zharfanw/fsaetest/Circuit/Gallery/AccumulatorCircuit.jpg

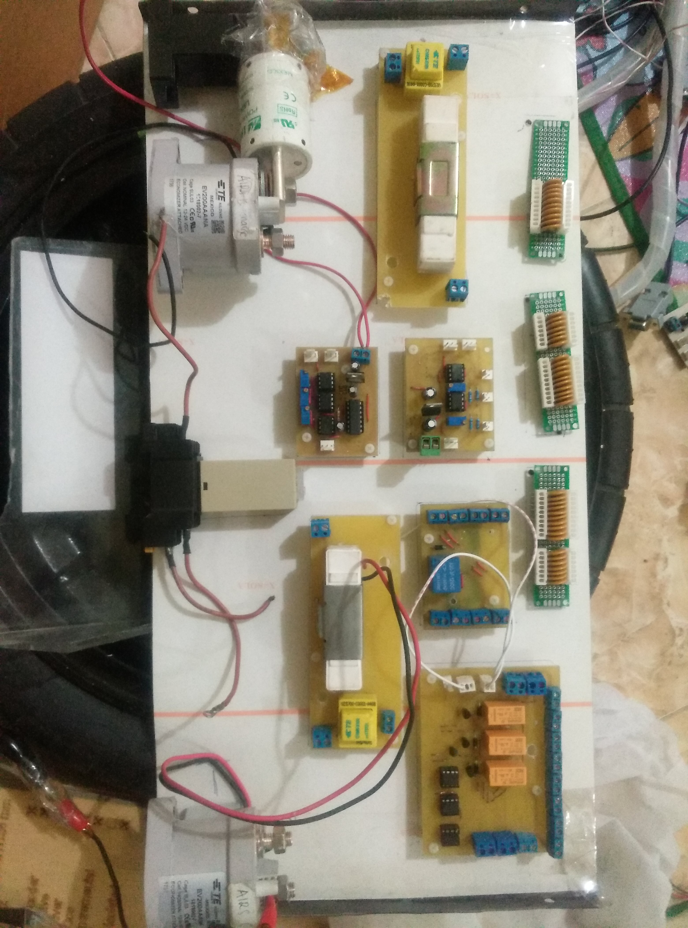
Circuit/Gallery/AccumulatorCircuit.jpg
