zharfanw/fsaetest/Circuit/Gallery/Diagram.png

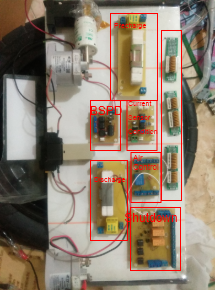
Circuit/Gallery/Diagram.png
