zharfanw/fsaetest/README.md

# UII's FSAE Car TEST

<!--stackedit_data:
eyJoaXN0b3J5IjpbNDYwMDQ0OTMzXX0=
-->
