zharfanw/fsaetest/Circuit/OrionBMSControl/FotoSementara.JPG

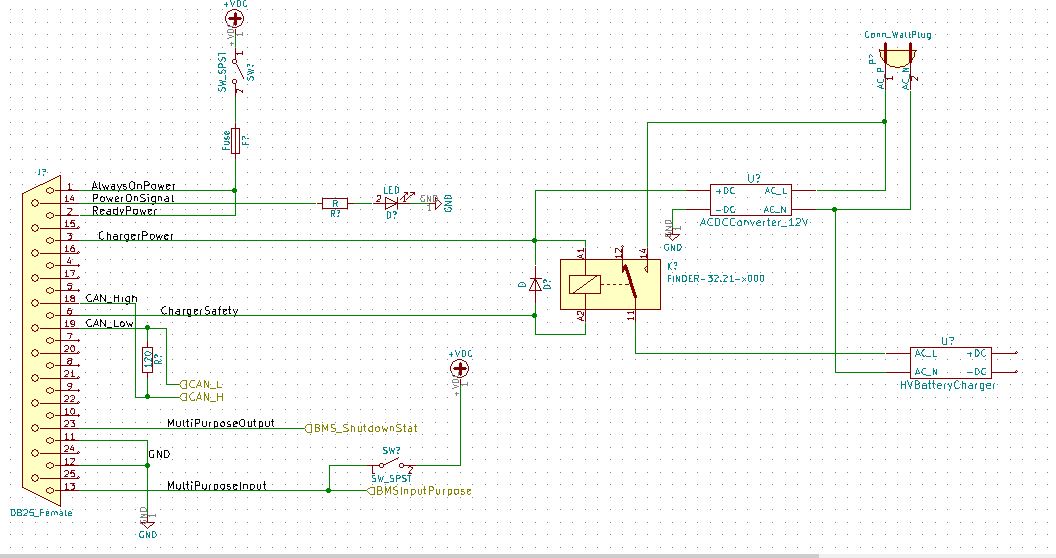
Circuit/OrionBMSControl/FotoSementara.JPG
