zharfanw/fsaetest/Circuit/OrionBMSControl/MultiIOPurpose.JPG

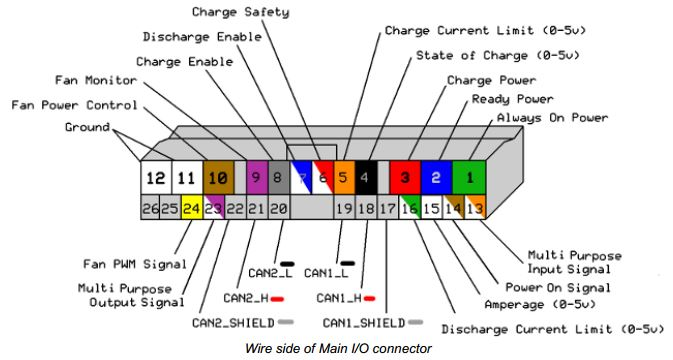
Circuit/OrionBMSControl/MultiIOPurpose.JPG
