zharfanw/fsaetest/Document/WiringData.ods

Sheet: NodeRegion
No | NodeRegion | NodeRegionSymbol
1 | Dashboard | D
2 | Pedal | P
3 | ECU | E
4 | Radiator | R
5 | PDM | PD
6 | Aki | BLV
7 | Rollbar | RB
8 | HVEnclosure | HVE
9 | Accumulator | Ac
10 | MotorController | MC
11 | Motor | M
12 | BMS | B
13 | HVEnclosure | Hve
14 | RightPanel | RP

Sheet: Node
No | Node1 |  |  | Node2 |  |  | LinkName |  |  |  | Note | Kabel | Links
 | NodeRegion | Node | NodeSym | NodeRegion | Node | NodeSym | From | To | Name | FULLNAME
1 | Pedal | +V_APP1 | +VAP1 | ECU | +V_APP1 | +VAP1 | P | E | +VAP1 | P_E_+VAP1 |  | 6P_AWG24 | https://www.tokopedia.com/s3-satriasecure/awg-kabel-6-jalur-bungkus-double-selongsong-bulat-isi-6-warna
2 | Pedal | APP1 | AP1 | ECU | APP1 | AP1 | P | E | AP1 | P_E_AP1
3 | Pedal | GND_APP1 | GAP1 | ECU | GND_APP1 | GAP1 | P | E | GAP1 | P_E_GAP1
4 | Pedal | +V_APP2 | +VAP2 | ECU | +V_APP2 | +VAP2 | P | E | +VAP2 | P_E_+VAP2
5 | Pedal | APP2 | AP1 | ECU | APP2 | AP1 | P | E | AP1 | P_E_AP1
6 | Pedal | GND_APP2 | GAP1 | ECU | GND_APP2 | GAP1 | P | E | GAP1 | P_E_GAP1
7 | Pedal | +V_BPP1 | +VBP1 | ECU | +V_BPP1 | +VBP1 | P | E | +VBP1 | P_E_+VBP1 |  | 6P_AWG24 | https://www.tokopedia.com/s3-satriasecure/awg-kabel-6-jalur-bungkus-double-selongsong-bulat-isi-6-warna
8 | Pedal | BPP1 | BP1 | ECU | BPP1 | BP1 | P | E | BP1 | P_E_BP1
9 | Pedal | GND_BPP1 | GBP1 | ECU | GND_BPP1 | GBP1 | P | E | GBP1 | P_E_GBP1
10 | Pedal | +V_BPP2 | +VBP2 | ECU | +V_BPP2 | +VBP2 | P | E | +VBP2 | P_E_+VBP2
11 | Pedal | BPP2 | BP2 | ECU | BPP2 | BP2 | P | E | BP1 | P_E_BP1
12 | Pedal | GND_BPP2 | GBP2 | ECU | GND_BPP2 | GBP2 | P | E | GBP1 | P_E_GBP1
13 | Pedal | BOTS_IN |  | Accumulator | Dashboard_SD_IN | D_SD_IN | P | Ac | SD | P_Ac_SD | SerialConnected | 2p_AWG20 | https://www.tokopedia.com/selectronix/high-quality-kabel-2-x-20-awg-1-meter?whid=0
14 | Pedal | BOTS_OUT |  | Accumulator | Dashboard_SD_IN | D_SD_OUT | P | Ac | SD | P_Ac_SD | SerialConnected
15 | Pedal | BRAKE_Switch_IN |  | PDM |  |  | P | PD | BS | P_PD_BS |  | 2p_AWG20 | https://www.tokopedia.com/selectronix/high-quality-kabel-2-x-20-awg-1-meter?whid=0
16 | Pedal | BRAKE_Switch_OUT |  | PDM |  |  | P | PD | BS | P_PD_BS
17 | Dashboard | CAN_H |  | ECU | CAN_H |  | D | E | CANH | D_E_CANH | ParalelConnected | 3p_AWG24 | https://www.tokopedia.com/s3-satriasecure/kabel-awg-24-3-jalur-double-bungkus-selongsong-awg24-bulat-isi-3-warna
18 | Dashboard | CAN_L |  | ECU | CAN_L |  | D | E | CANL | D_E_CANL | ParalelConnected
19 | Dashboard | DriveMode_In | FD_IN | MotorController | ForwardDigital_IN |  | D | MC | FD | D_MC_FD | SerialConnected | 8P_AWG24 | https://www.tokopedia.com/s3-satriasecure/awg24-kabel-8-jalur-bungkus-double-selongsong-awg24-bulat-isi-8-warna
20 | Dashboard | DriveMode_Out | FD_OUT | MotorController | ForwardDigital_OUT |  | D | MC | FD | D_MC_FD | SerialConnected
21 | Dashboard | ReverseDigInput_IN | RD_IN | MotorController | ReverseDigInput_IN | RD_IN | D | MC | RD | D_MC_RD
22 | Dashboard | ReverseDigInput_OUT | RD_OUT | MotorController | ReverseDigInput_OUT | RD_OUT | D | MC | RD | D_MC_RD
23 | Dashboard | MotorCAN_H | MCAN_H | MotorController | MotorCAN_H | MCAN_H | D | MC | MCAN_H | D_MC_MCAN_H
24 | Dashboard | MotorCAN_L | MCAN_L | MotorController | MotorCAN_L | MCAN_L | D | MC | MCAN_L | D_MC_MCAN_L
25 | Dashboard | VCC | VDB | PDM |  |  | D | PD | VDB | D_PD_VDB |  | 2p_AWG20 | https://www.tokopedia.com/selectronix/high-quality-kabel-2-x-20-awg-1-meter?whid=0
26 | Dashboard | GND | GDB | PDM |  |  | D | PD | GDB | D_PD_GDB
27 | Dashboard | BMS_Indicator | BMSIN | Accumulator | BMS_Indicator | BMSIN | D | Ac | BMSIN | D_Ac_BMSIN |  | 4p_AWG24 | https://www.tokopedia.com/s3-satriasecure/kabel-awg-24-4-jalur-double-bungkus-selongsong-awg24-bulat-isi-4-warna
28 | Dashboard | IMD_Indicator | IMDIN | Accumulator | IMD_Indicator | IMDIN | D | Ac | IMDIN | D_Ac_IMDIN
29 | Dashboard | GND_Indicator | GNDIN | Accumulator | GND_Indicator | GNDIN | D | Ac | GNDIN | D_Ac_GNDIN
30 | Dashboard | MotorControllerIgnition_IN | MCIG_IN | MotorController | GND_Ignition | MCIG_IN | D | MC | MCIG_IN | D_MC_MCIG_IN | SerialConnected | 2p_AWG20 | https://www.tokopedia.com/selectronix/high-quality-kabel-2-x-20-awg-1-meter?whid=0
31 | Dashboard | MotorControllerIgnition_OUT | MCIG_OUT | MotorController | Ignition | MCIG_OUT | D | MC | MCIG_OUT | D_MC_MCIG_OUT | SerialConnected
32 | Dashboard | Shutdown_Dashboard_IN | SD_DB_IN | Accumulator | Shutdown_Dashboard_IN | SD_DB_IN | D | Ac | SD_DB_IN | D_Ac_SD_DB_IN |  | 2p_AWG20 | https://www.tokopedia.com/selectronix/high-quality-kabel-2-x-20-awg-1-meter?whid=0
33 | Dashboard | Shutdown_Dashboard_OUT | SD_DB_OUT | Accumulator | Shutdown_Dashboard_OUT | SD_DB_OUT | D | Ac | SD_DB_OUT | D_Ac_SD_DB_OUT
34 | ECU | VCC | VECU | PDM |  |  | E | PD | VECU | E_PD_VECU |  | 2p_AWG20
35 | ECU | GND | GECU | PDM |  |  | E | PD | GECU | E_PD_GECU
36 | ECU | MotorControllerIgnition_IN | MCIG_IN | MotorController | GND_Ignition |  | E | MC | MCIG_IN | E_MC_MCIG_IN | SerialConnected | 2p_AWG20
37 | ECU | MotorControllerIgnition_OUT | MCIG_OUT | MotorController | Ignition |  | E | MC | MCIG_OUT | E_MC_MCIG_OUT | SerialConnected
38 | ECU | Vthrottle_MotorController | VTMC | MotorController | ThrottleVCCOut |  | E | MC | VTMC | E_MC_VTMC |  | 3p_AWG24 | https://www.tokopedia.com/s3-satriasecure/kabel-awg-24-3-jalur-double-bungkus-selongsong-awg24-bulat-isi-3-warna
39 | ECU | SignalThrottle_MotorController | STMC | MotorController | ThrottleInput |  | E | MC | STMC | E_MC_STMC
40 | ECU | GNDThrottle_MotorController | GTMC | MotorController | GND_Ignition |  | E | MC | GTMC | E_MC_GTMC | ParallelConnected
41 | ECU | Vbrake | VB | Accumulator | V brakeSensor |  | E | Ac | VB | E_Ac_VB |  | 3p_AWG24 | https://www.tokopedia.com/s3-satriasecure/kabel-awg-24-3-jalur-double-bungkus-selongsong-awg24-bulat-isi-3-warna
42 | ECU | Sbrake | SB | Accumulator | S_brakeSensor |  | E | Ac | SB | E_Ac_SB
43 | ECU | Gbrake | GB | Accumulator | G_BrakeSensor |  | E | Ac | GB | E_Ac_GB
44 | BMS | AlwaysOnPower%PowerOnSignal | VBMS | PDM |  |  | B | PD | VBMS | B_PD_VBMS |  | 2p_AWG20
45 | BMS | GND | GBMS | PDM |  |  | B | PD | GBMS | B_PD_GBMS
46 | BMS | CANH | CANH | ECU | CAN_H |  | B | E | CANH | B_E_CANH |  | 3p_AWG24
47 | BMS | CANL | CANL | ECU | CAN_L |  | B | E | CANL | B_E_CANL
48 | BMS | MultiPurposeInput | BMPI | ECU | BMS_MultiPurposeInput | BMPI | B | E | BMPI | B_E_BMPI |  | 2p_AWG20
49 | BMS | MultiPurposeOuput | BMPO | Accumulator | BMS_Input | BMSI | B | Ac | BMPO | B_Ac_BMPO |  | 2p_AWG20
50 | Accumulator | +LV | Vac | PDM |  |  | Ac | PD | Vac | Ac_PD_Vac |  | 2p_AWG20
51 | Accumulator | GND | Gac | PDM |  |  | Ac | PD | Gac | Ac_PD_Gac
52 | Accumulator | SmallHV+ | SHV+ | HVEnclosure | HV+ |  | Ac | HVE | SHV+ | Ac_HVE_SHV+ |  | 2p_AWG20
53 | Accumulator | SmallHV- | SHV- | HVEnclosure | HV- |  | Ac | HVE | SHV- | Ac_HVE_SHV-
54 | Accumulator | DischargeSignal | DS | HVEnclosure | DischargeSignal |  | Ac | HVE | DS | Ac_HVE_DS |  | 2p_AWG20
55 | Accumulator | Discharge_GND | DG | HVEnclosure | Discharge_GND |  | Ac | HVE | DG | Ac_HVE_DG
56 | HVEnclosure | TSALV+ | TSV+ | Rollbar | +V_TSALSIGNAL |  | HVE | RB | TSV+ | HVE_RB_TSV+ |  | 2p_AWG20
57 | HVEnclosure |  | TSV- | Rollbar | -V_TSALSIGNAL |  | HVE | RB | TSV- | HVE_RB_TSV-
58 | HVEnclosure | TSALV- | TSMP+ | Rollbar | TSMP_HV+ |  | HVE | RB | TSMP+ | HVE_RB_TSMP+ |  | 2p_AWG20
59 | HVEnclosure | TSMP_HV+ | TSMP- | Rollbar | TSMP_HV- |  | HVE | RB | TSMP- | HVE_RB_TSMP-
60 | HVEnclosure | TSMP_R_HV+ | RTSMP+ | Rollbar | TSMP_R_HV+ |  | HVE | RB | RTSMP+ | HVE_RB_RTSMP+ |  | 2p_AWG20
61 | HVEnclosure | TSMP_R_HV+ | RTSMP- | Rollbar | TSMP_R_HV+ |  | HVE | RB | RTSMP- | HVE_RB_RTSMP-
62 | Rollbar | TSMP_GND | GMP | PDM |  |  | RB | PD | GMP | RB_PD_GMP |  | 2p_AWG20
63 | RightPanel | Reset_IN | Rin | Accumulator | Reset_In |  | RP | Ac | Rin | RP_Ac_Rin |  | 2p_AWG20
64 | RightPanel | Reset_Out | Rout | Accumulator | Reset_Out |  | RP | Ac | Rout | RP_Ac_Rout
65 | RightPanel | LV_MS_IN | LVMSIn | PDM |  |  | RP | PD | LVMSIn | RP_PD_LVMSIn |  | 2p_AWG20
66 | RightPanel | LV_MS_OUT | LVMSOut | PDM |  |  | RP | PD | LVMSOut | RP_PD_LVMSOut
 | RightPanel | Shutdown_TSMS_IN | SD_TS_IN | Accumulator |  |  | RP | Ac | SD_TS_IN | RP_Ac_SD_TS_IN |  | 2p_AWG20
 | RightPanel | Shutdown_TSMS_IN | SD_TS_OUT | Accumulator |  |  | RP | Ac | SD_TS_OUT | RP_Ac_SD_TS_OUT
67 | Rollbar | Shutdown_Rollbar_IN | SD_RB_IN | Accumulator | Shutdown_IN |  | RB | Ac | SD_RB_IN | RB_Ac_SD_RB_IN |  | 2p_AWG20
68 | Rollbar | Shutdown_Rollbar_OUT | SD_RB_OUT | Accumulator | Shutdown_OUT |  | RB | Ac | SD_RB_OUT | RB_Ac_SD_RB_OUT
69 | MotorController | SSIClock+ | SSICK+ | Motor | SSIClock+ | SSICK+ | MC | M | SSICK+ | MC_M_SSICK+ |  | 8P_AWG24 | https://www.tokopedia.com/s3-satriasecure/awg24-kabel-8-jalur-bungkus-double-selongsong-awg24-bulat-isi-8-warna
70 | MotorController | SSIClock- | SSICK- | Motor | SSIClock- | SSICK- | MC | M | SSICK- | MC_M_SSICK-
71 | MotorController | SSIData+ | SSID+ | Motor | SSIData+ | SSID+ | MC | M | SSID+ | MC_M_SSID+
72 | MotorController | SSIData- | SSID- | Motor | SSIData- | SSID- | MC | M | SSID- | MC_M_SSID-
73 | MotorController | Feedback_VCC | FBV | Motor | Feedback_VCC | FBV | MC | M | FBV | MC_M_FBV
74 | MotorController | Feedback_GND | FBG | Motor | Feedback_GND | FBG | MC | M | FBG | MC_M_FBG
75 | MotorController | MotorTemperature | MT | Motor | MotorTemperature | MT | MC | M | MT | MC_M_MT
76 | Radiator | Radiator_FAN_V+ | RFV+ | PDM |  |  | R | PD | RFV+ | R_PD_RFV+ |  | 2p_AWG20
77 | Radiator | Radiator_FAN_V- | RFV- | PDM |  |  | R | PD | RFV- | R_PD_RFV-
78 | Radiator | Radiator_Pump_V+ | RPV+ | PDM |  |  | R | PD | RPV+ | R_PD_RPV+ |  | 2p_AWG20
79 | Radiator | Radiator_Pump_V- | RPV- | PDM |  |  | R | PD | RPV- | R_PD_RPV-
80 | Aki | V+ | V+ | PDM |  |  | BLV | PD | V+ | BLV_PD_V+
81 | Aki | V- | V- | PDM |  |  | BLV | PD | V- | BLV_PD_V-

Sheet: Ukuran
No | From | To | Size
1 | S1 | Pedal | 90
 | S1 | Dashboard | 90
 | S2 | ECU | 30
 | S1 | S2 | 84
 | S2 | S4 | 49
 | S4 | S3 | 33
 | S3 | Rollbar | 108
 | S3 | RightPanel | 37
 | S4 | MotorController | 83
 | S4 | PDM | 83
 | S4 | HVEnclosure | 83
 | S4 | S5 | 55
 | S5 | BMS | 53
 | S5 | Accumulator | 53
 | S5 | Aki | 53
 | S5 | RadiatorFan | 90
 | S5 | BrakeLight | 90
 | Pedal | ECU | 120
 | Pedal | Accumulator | 282
 | Pedal | PDM | 306
 | ECU | PDM | 246
 | ECU | BMS | 222 | 222
 | ECU | MotorController | 246 | 246
 | ECU | Accumulator | 222 | 222
 | Dashboard | PDM | 306 | 306
 | Dashboard | Accumulator | 282 | 282
 | Dashboard | MotorController | 293 | 293 | 306
 | Dashboard | BMS | 282
 | MotorController | PDM | 169
 | MotorController | Motor | 150
 | BMS | Accumulator | 90
 | Accumulator | PDM | 240 | 240
 | Accumulator | HVEnclosure | 240 | 240
 | Accumulator | Rollbar | 227 | 227
 | Accumulator | RightPanel | 227 | 227
 | HVEnclosure | Rollbar | 224 | 224
 | HVEnclosure | PDM | 169
 | RightPanel | PDM | 153 | 153
 | Radiator | PDM | 277 | 277
 | PDM | BrakeLight | 277
