zharfanw/fsaetest/Circuit/All General Wiring/All General Wiring.pdf

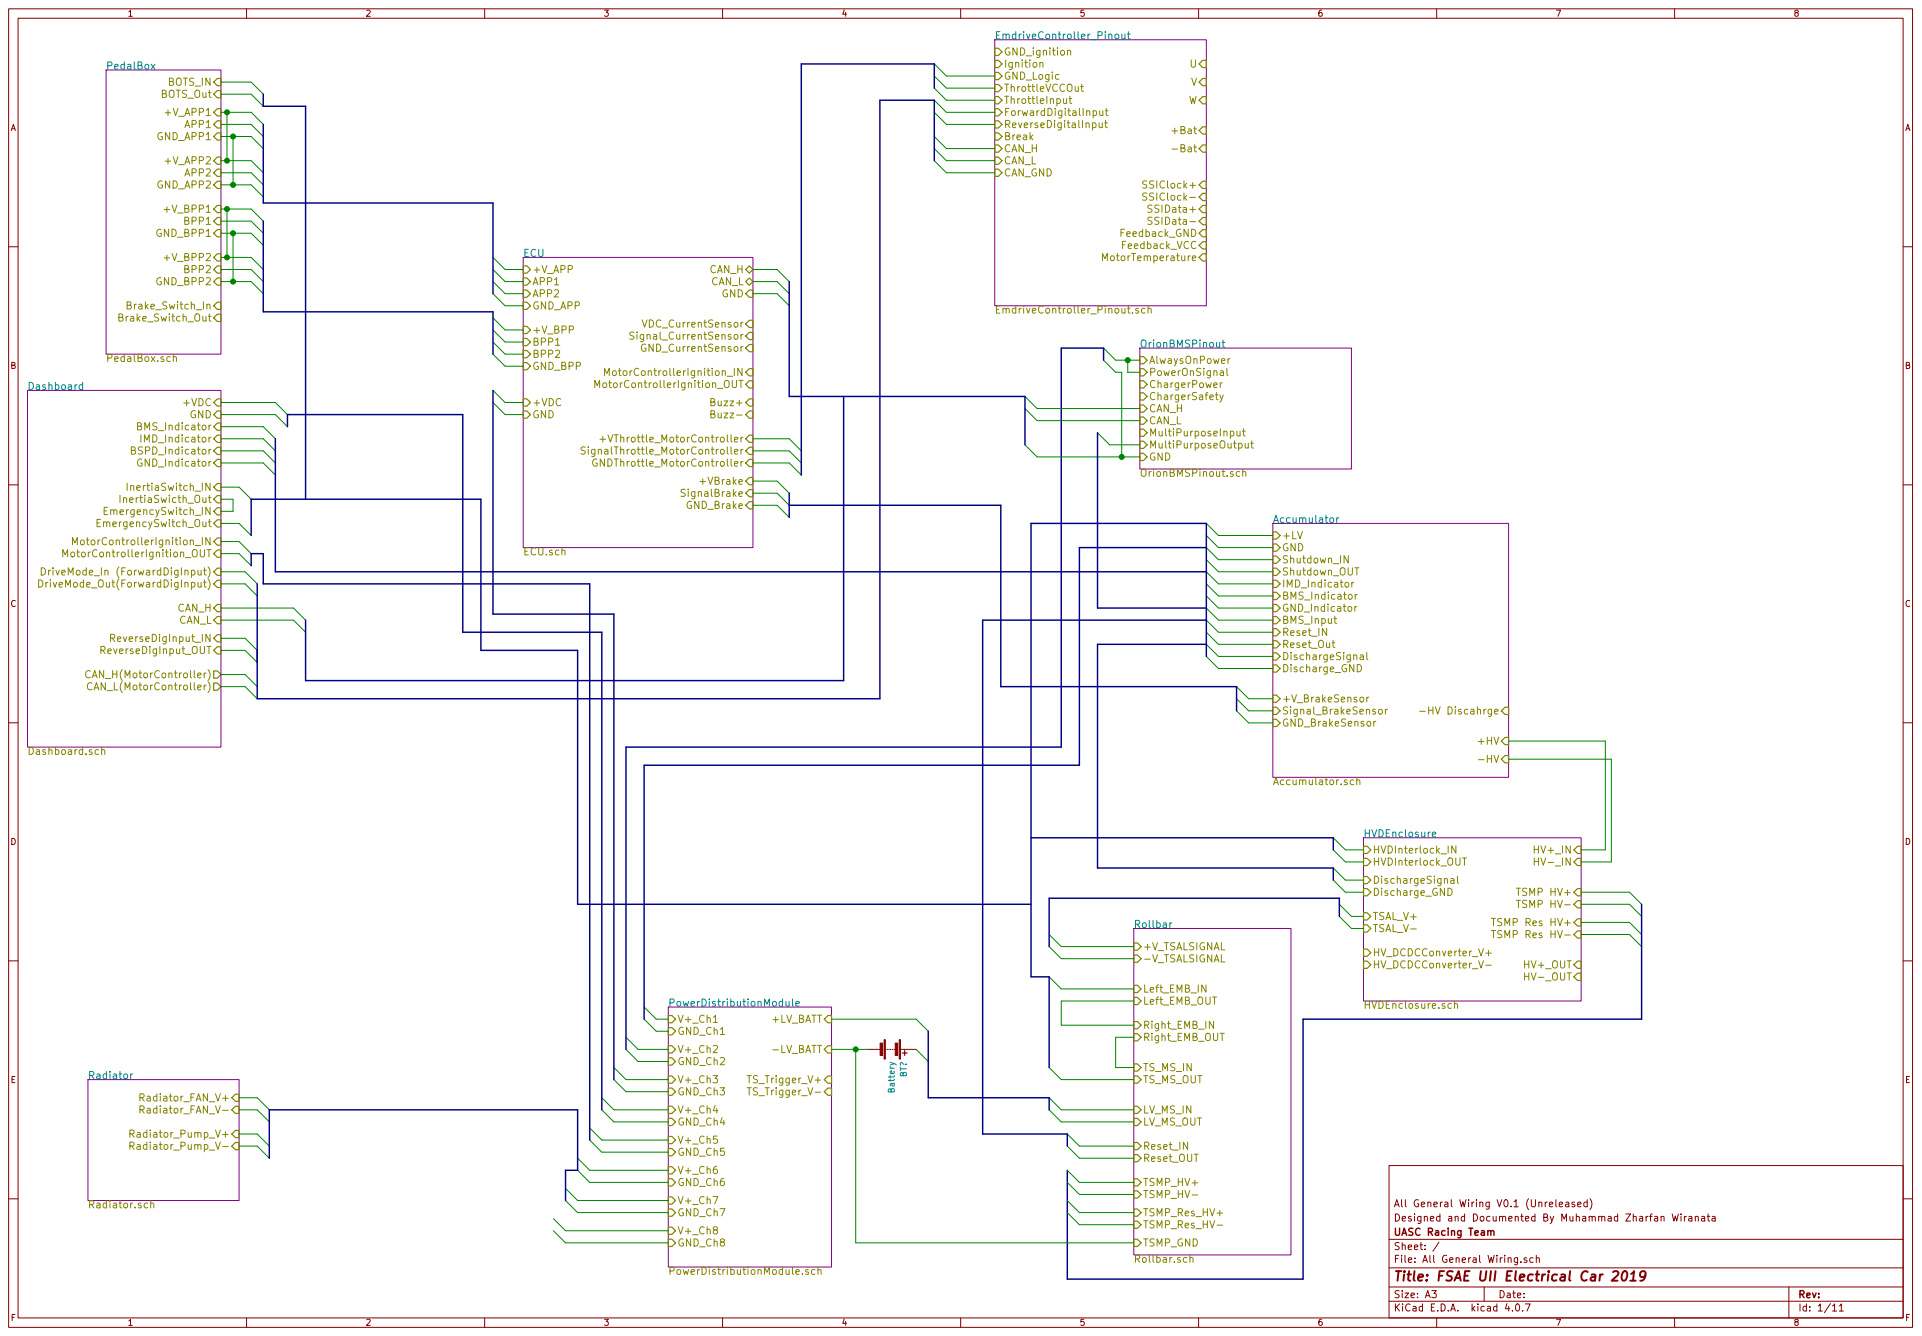
[picture p6: page 1]
