zharfanw/fsaetest/Circuit/OldSchematic/Shutdown/AIRControl.PDF

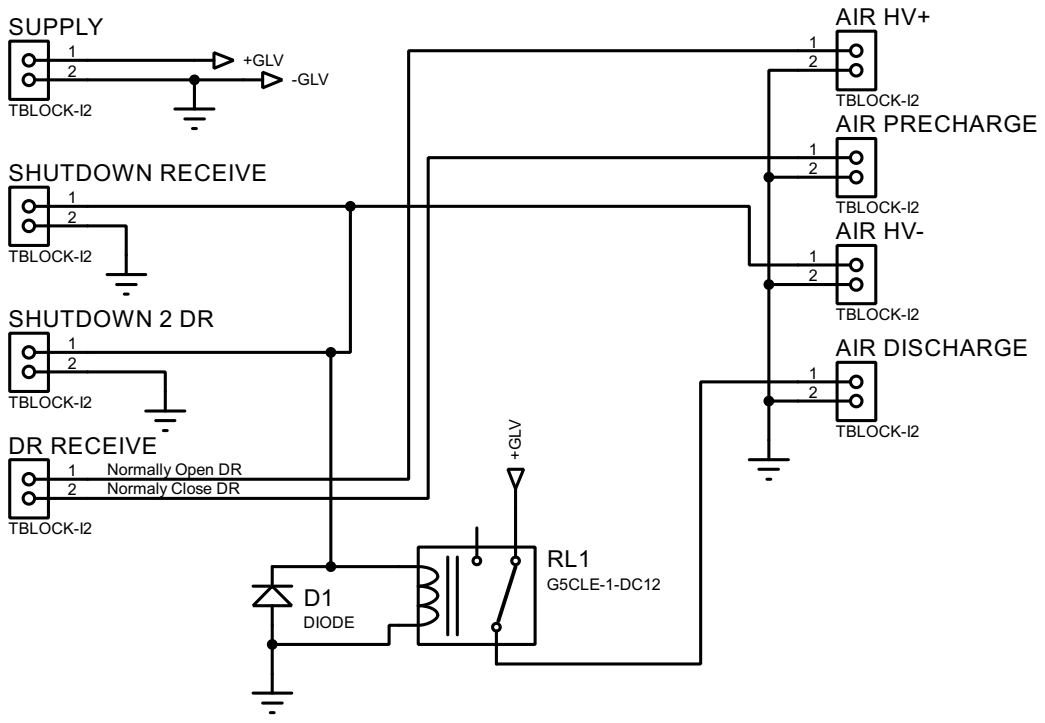
[picture p7: page 1]

FILE NAME:
DESIGN TITLE: AIRControl.pdsprj
