zharfanw/fsaetest/Circuit/OldSchematic/Shutdown/BSPD_UASC.PDF

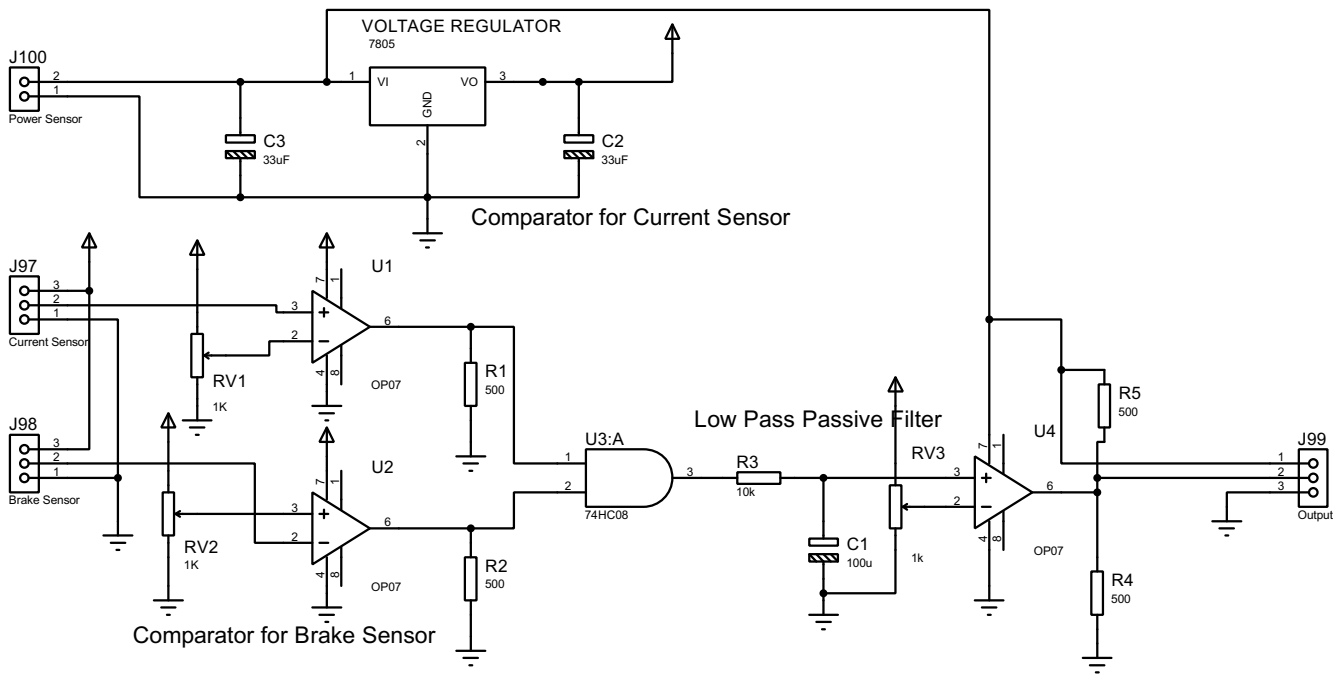
[picture p8: page 1]
