zharfanw/fsaetest/Circuit/OldSchematic/Shutdown/BSPD_UASC_PCB.PDF

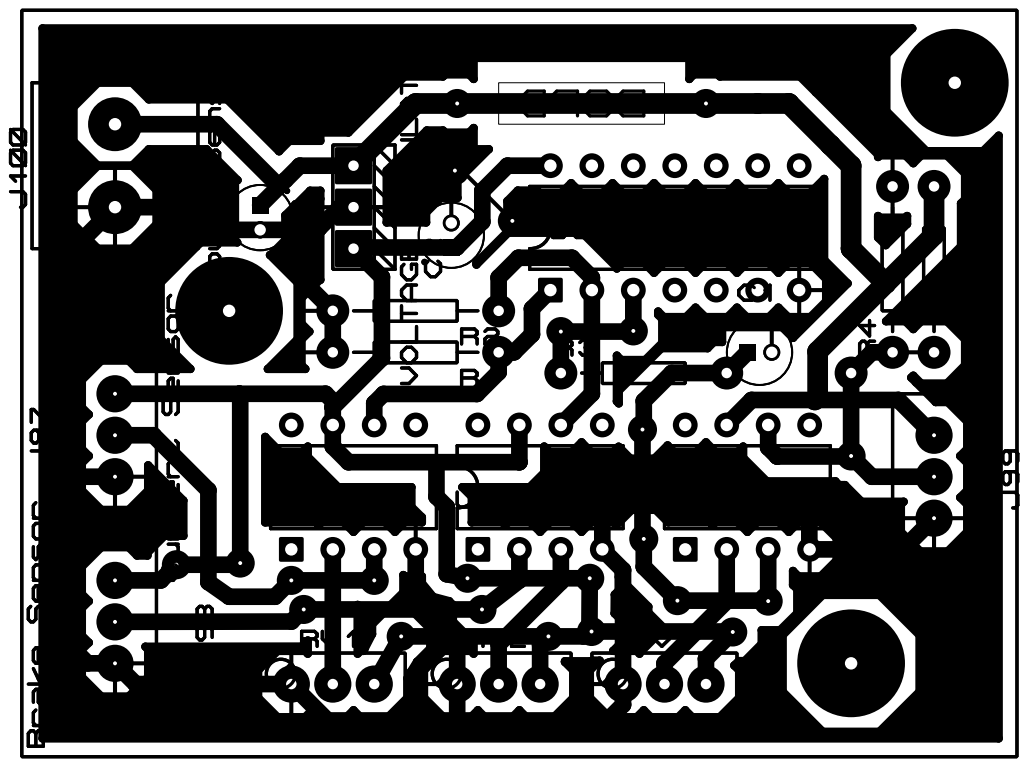
[picture p9: page 1]
