zharfanw/fsaetest/Circuit/OldSchematic/Shutdown/BSPDv2.PDF

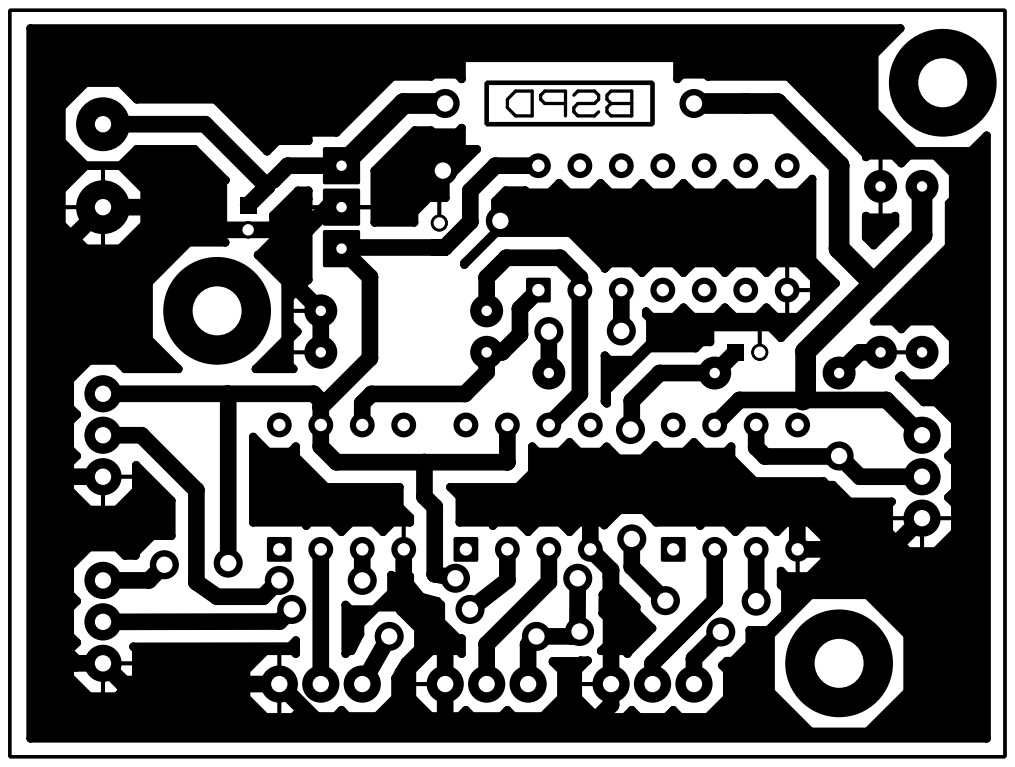
[picture p10: page 1]
