zharfanw/fsaetest/Circuit/OldSchematic/Shutdown/CurrentSensor_SignalConditioning.PDF

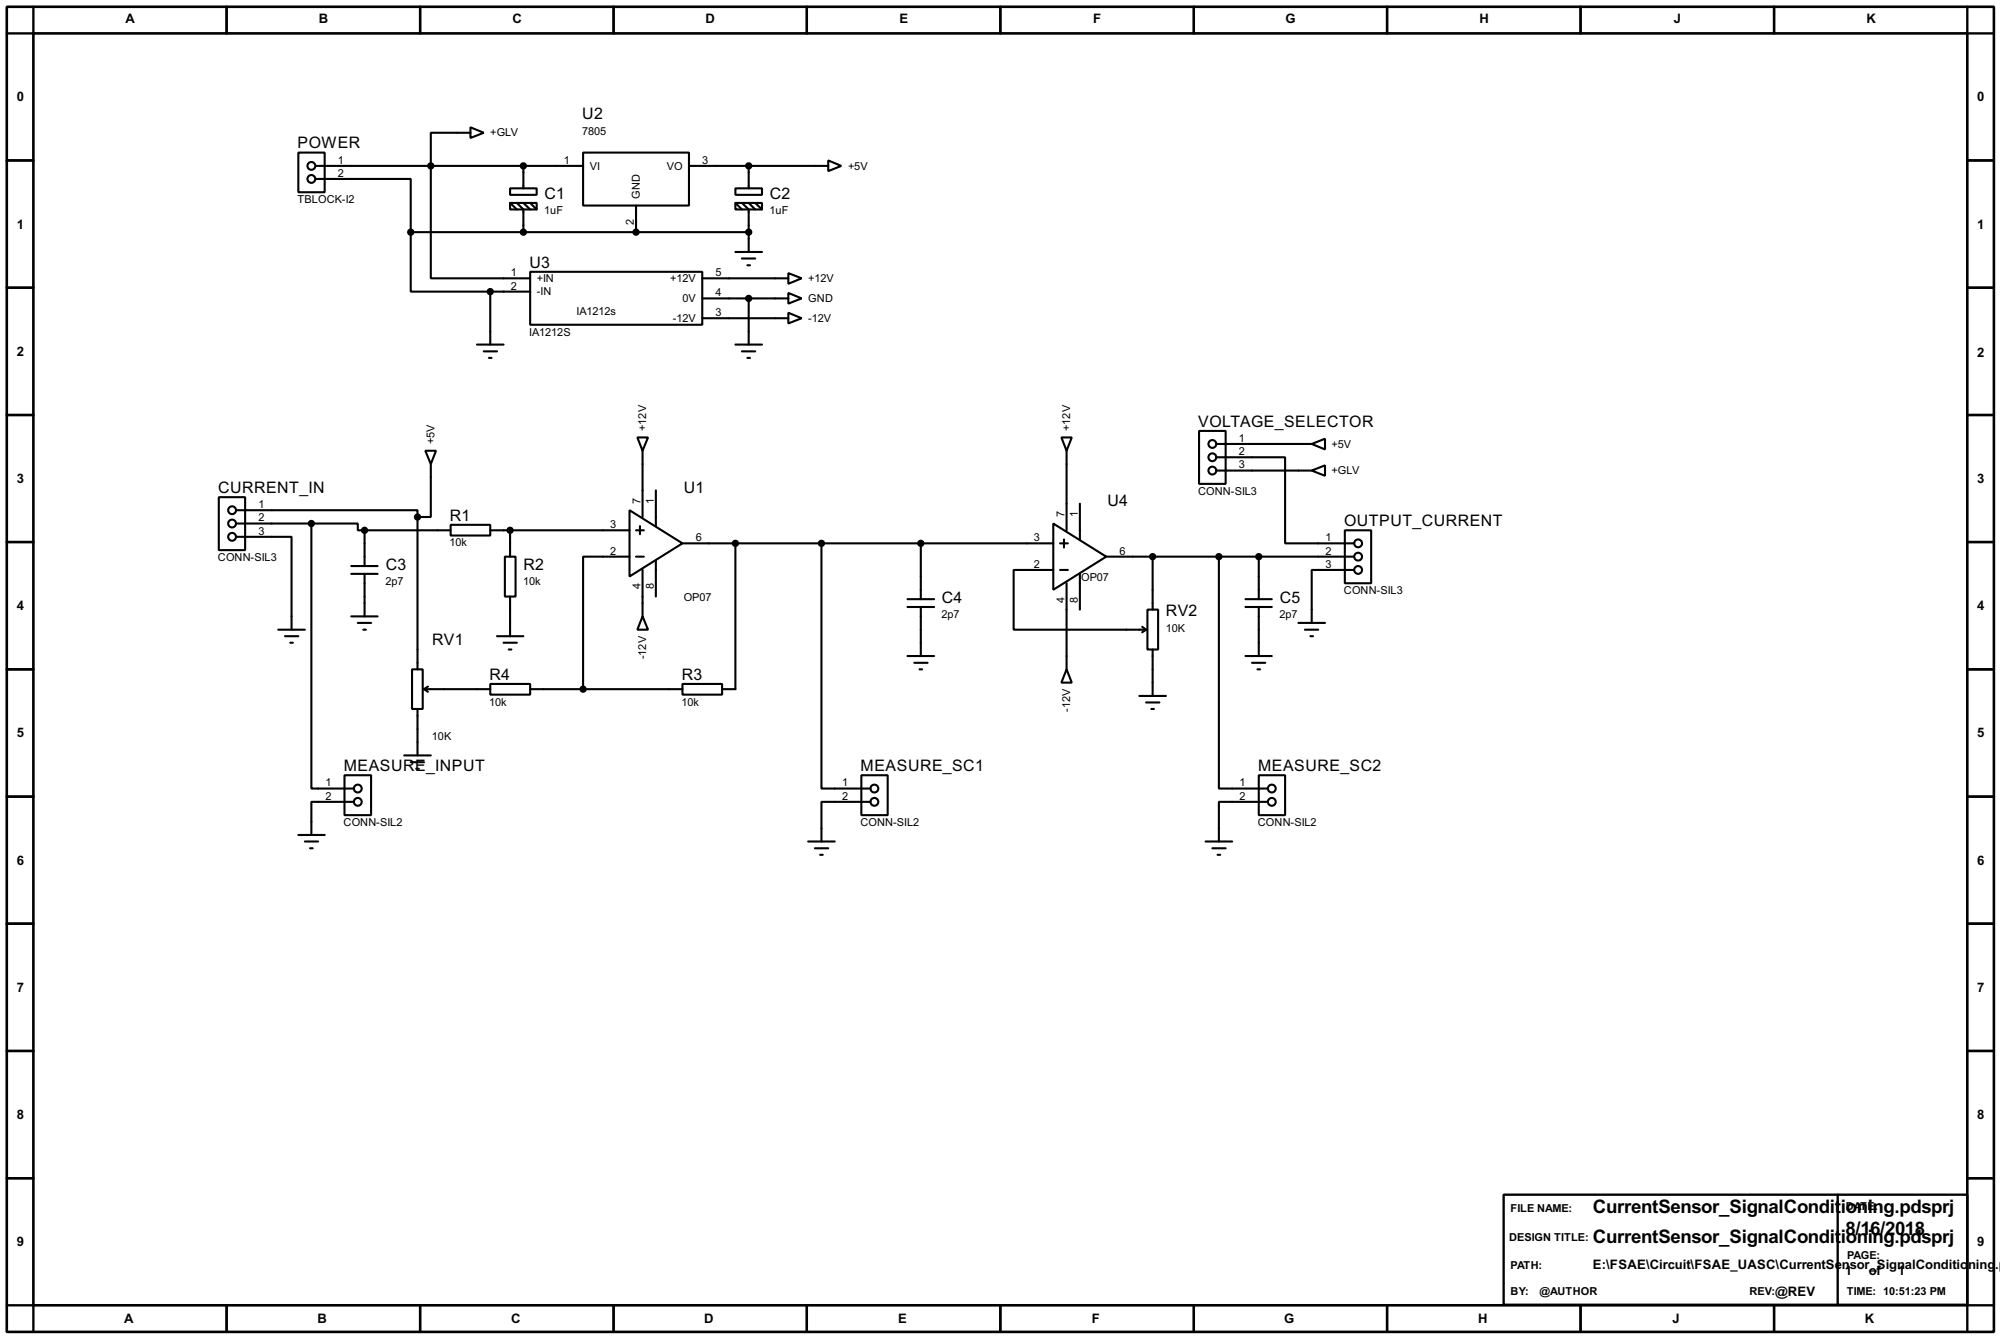
[picture p11: page 1]
