zharfanw/fsaetest/Circuit/OldSchematic/Shutdown/CurrentSensor_SignalConditioning_PCB.PDF

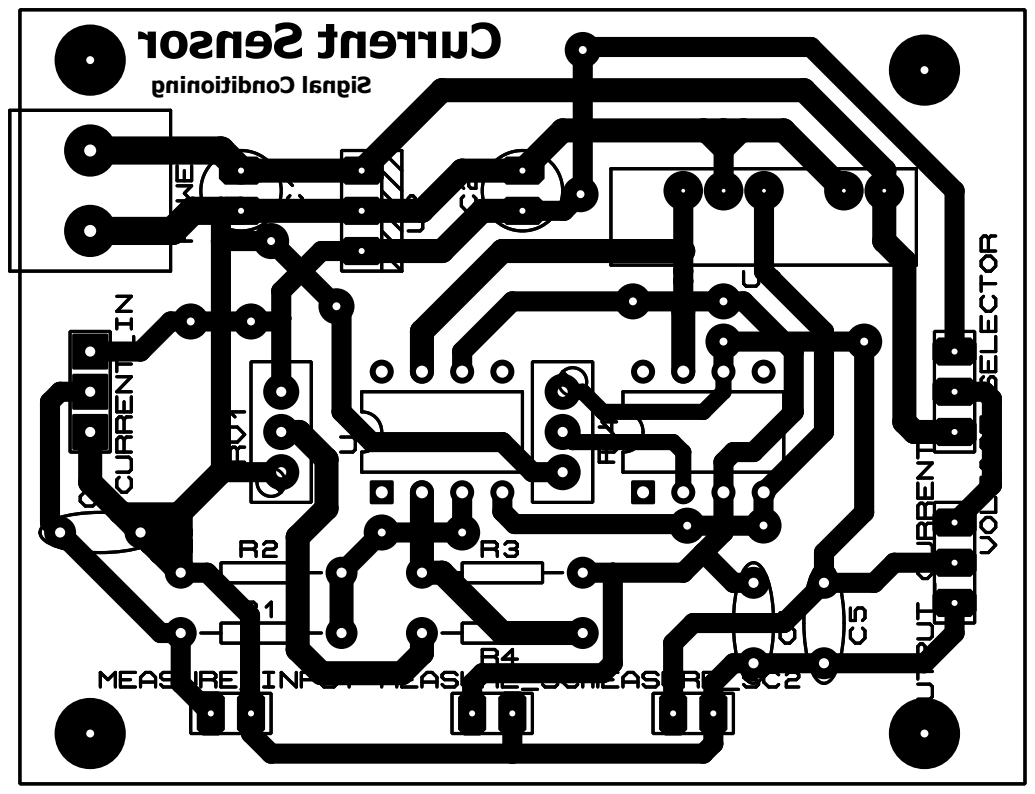
[picture p12: page 1]

gni noiti dnoCl angi S
