zharfanw/fsaetest/Circuit/OldSchematic/Shutdown/Shutdown_Circuitv3.PDF

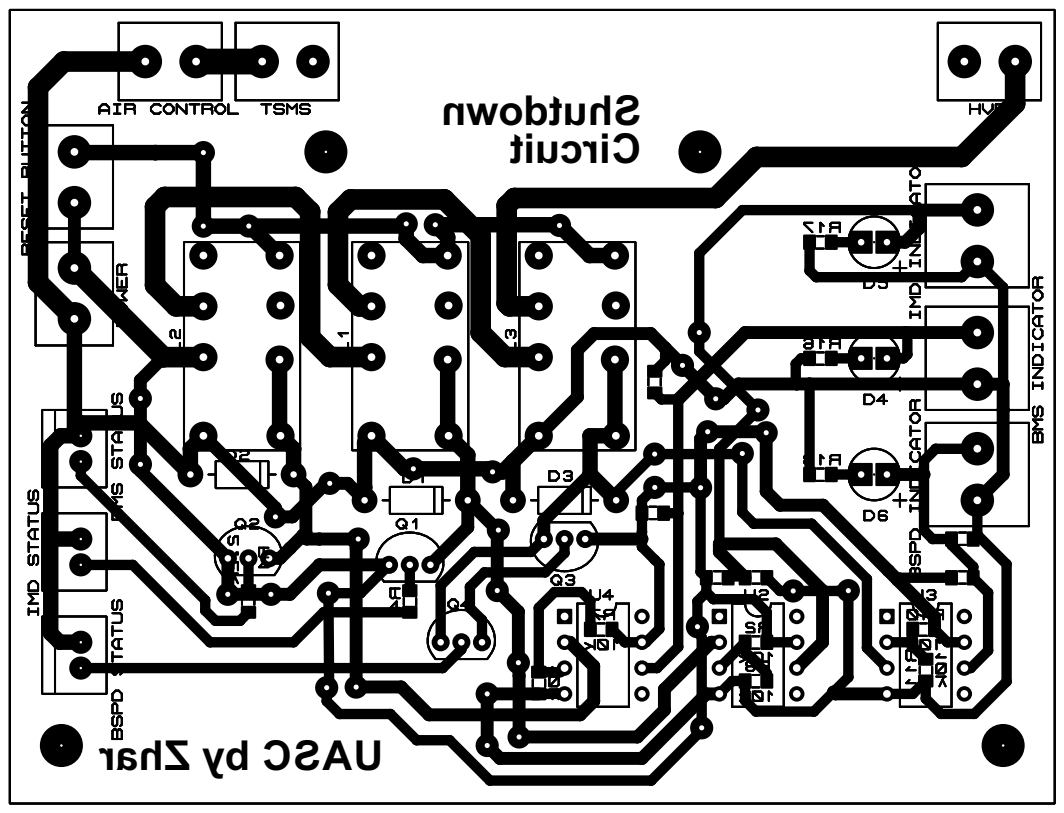
[picture p13: page 1]
