zharfanw/fsaetest/Circuit/OldSchematic/Shutdown/Shutdown_Circuitv3_Schematic.PDF

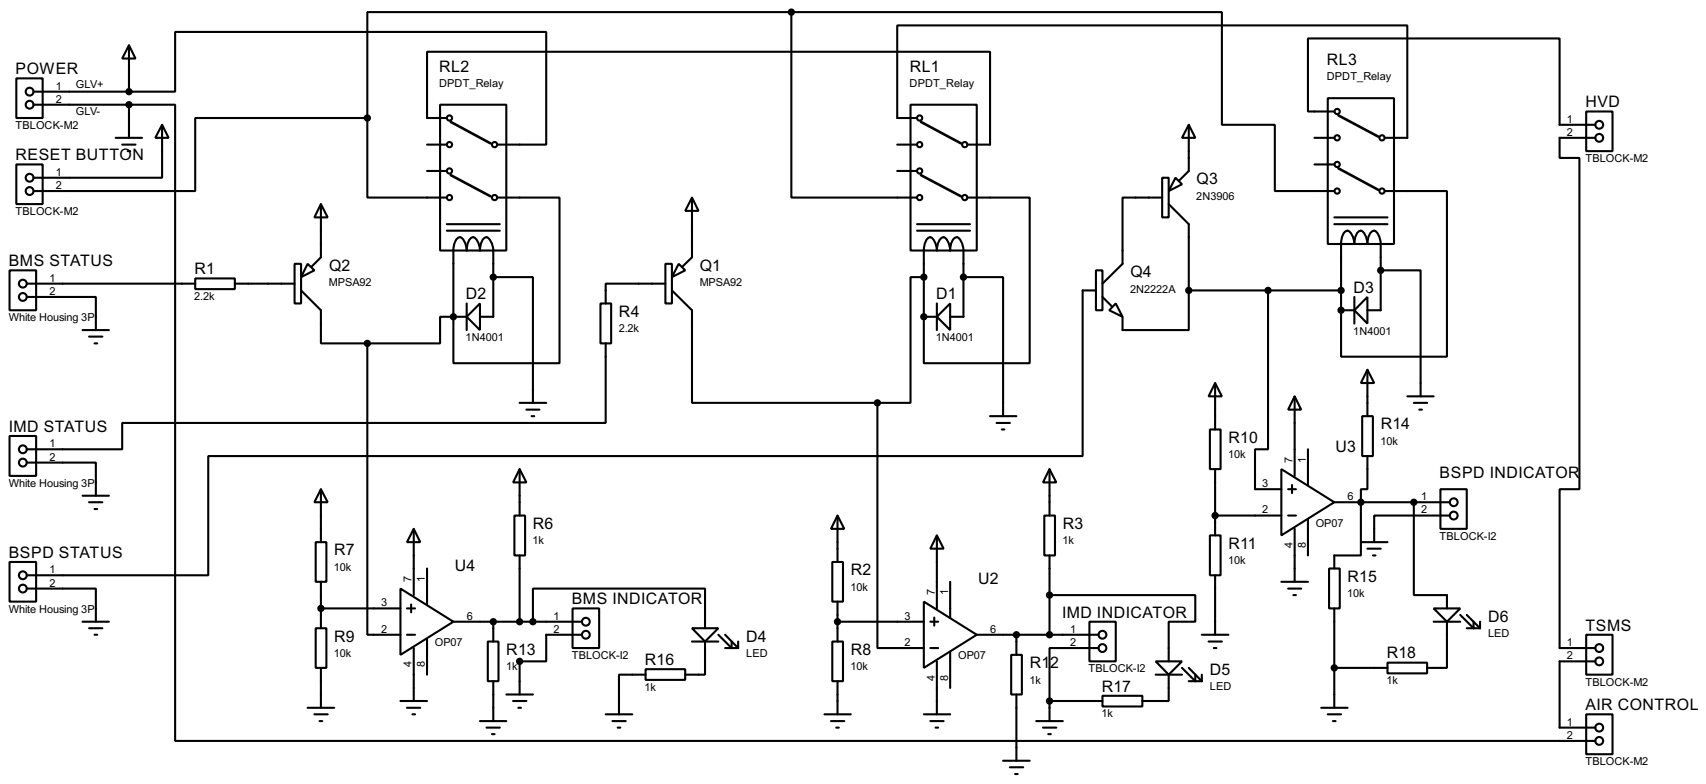
[picture p14: page 1]
