zharfanw/fsaetest/(list of files, drawings)

Other design files:
Circuit/OldSchematic/Shutdown/Shutdown_Circuitv3.pdsprj
Circuit/ShutdownSystem/ShutdownSystem.dsn
