zharfanw/fsaetest/Circuit/ShutdownSystem/ShutdownSystem.kicad_pcb

## KiCad design Circuit/ShutdownSystem/ShutdownSystem.kicad_pcb (2019-12-07)

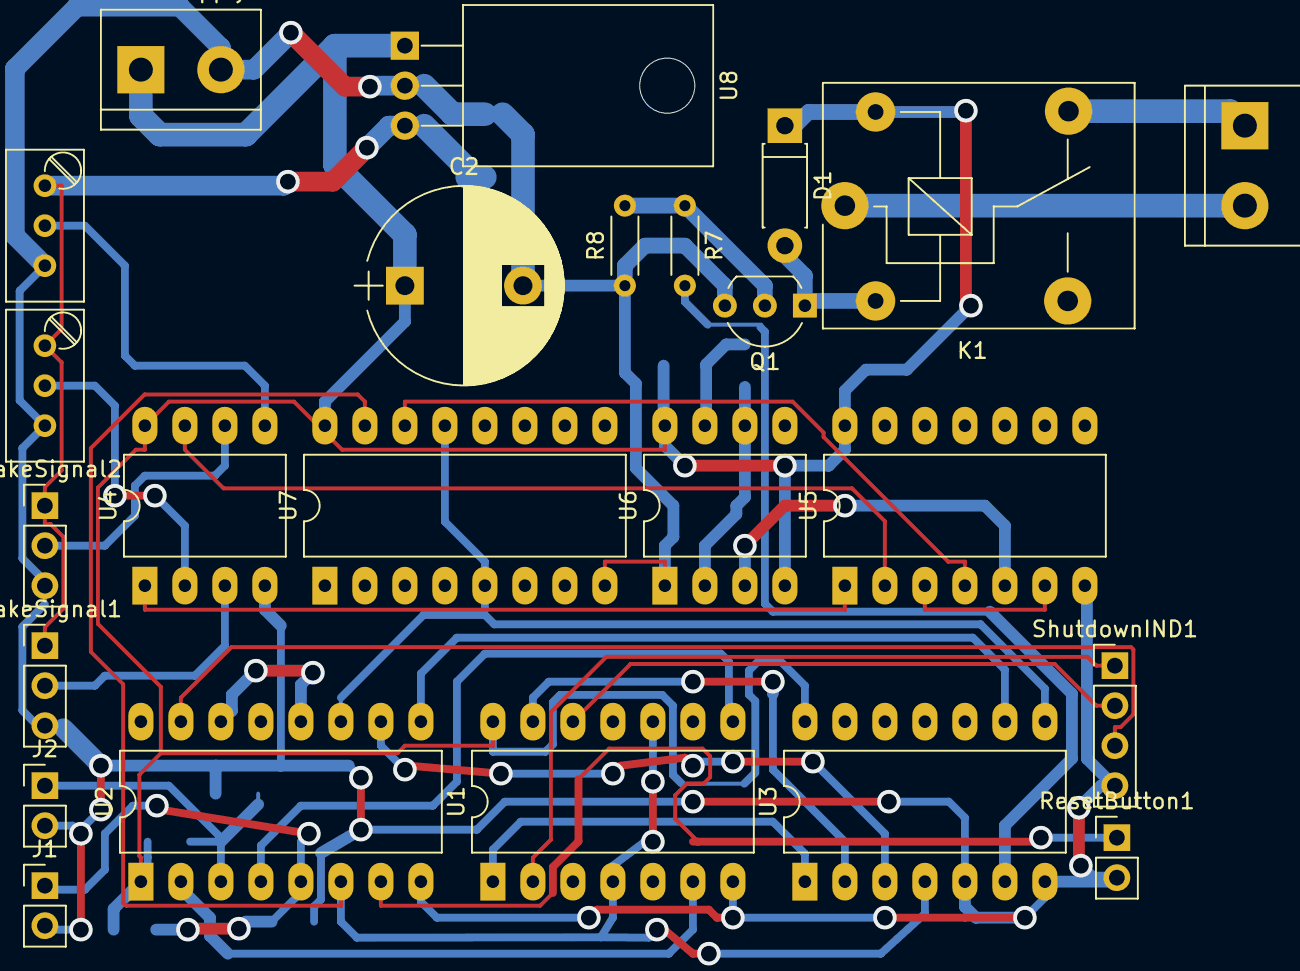
[picture p15: board ShutdownSystem.kicad_pcb from above]

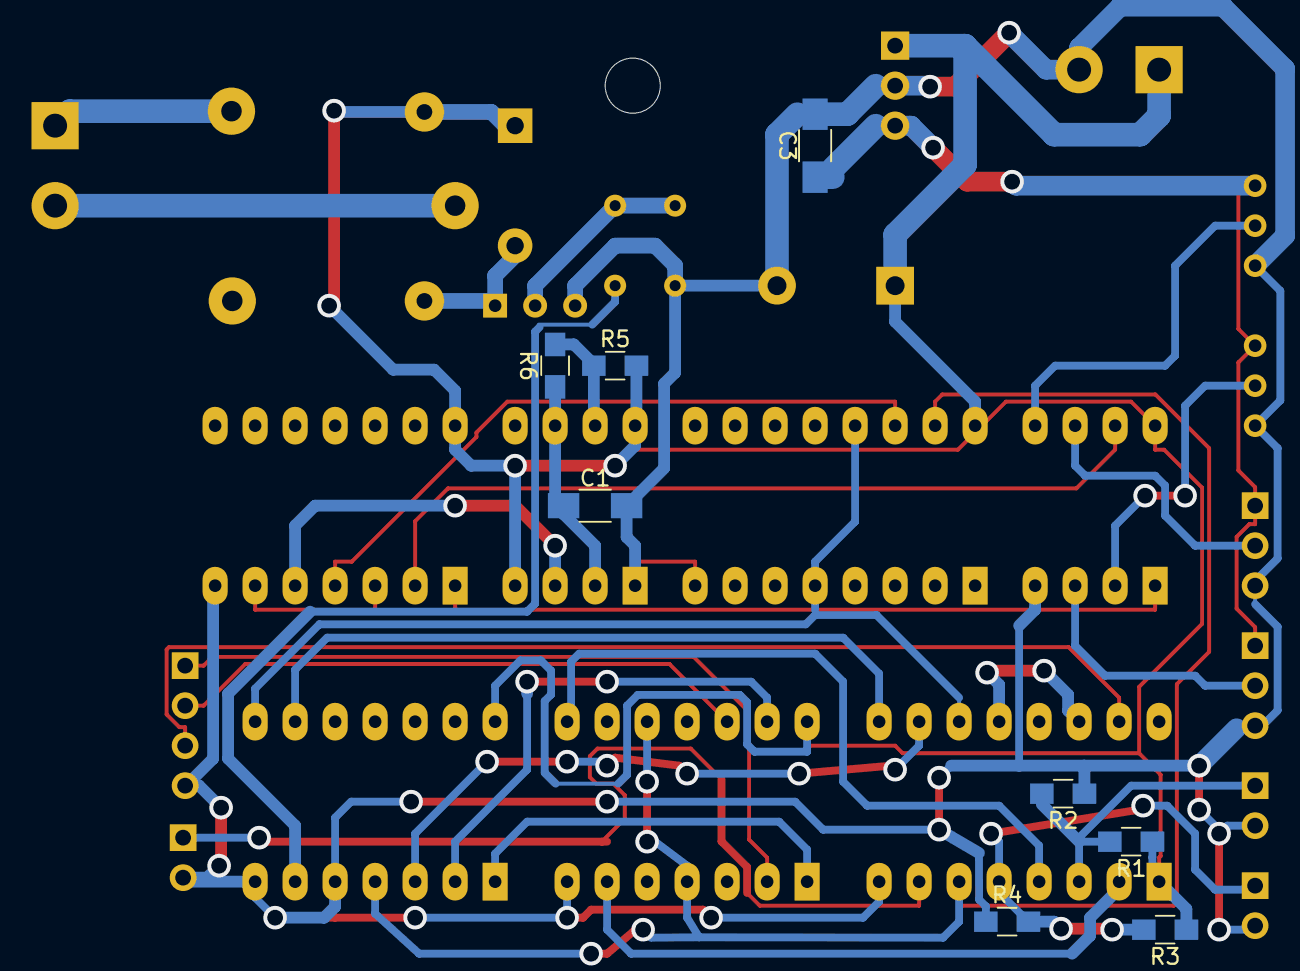
[picture p16: board ShutdownSystem.kicad_pcb from below]

Board: 2 copper layers, 32 parts (8 on the bottom side), 34 nets.

Parts:
BrakeSignal1, BrakeSignal2: XH_3p; Pin_Header_Straight_1x03_Pitch2.54mm
C1: 4u7F; C_1206_HandSoldering
C2: 100uF; CP_Radial_D12.5mm_P7.50mm
C3: 10uF; C_1206_HandSoldering
D1: D; D_DO-41_SOD81_P7.62mm_Horizontal
J1, J2: Conn_01x02_Male; Pin_Header_Straight_1x02_Pitch2.54mm
K1: SANYOU_SRD_Form_C; Relay_SPDT_SANYOU_SRD_Series_Form_C
PowerSupply1: TerminalBlock_2p; TerminalBlock_bornier-2_P5.08mm
Q1: 2N3906; TO-92_Inline_Wide
R1, R2, R3, R4: R; R_0805_HandSoldering
R5: 3k; R_0805_HandSoldering
R6: 13k; R_0805_HandSoldering
R7, R8: R; R_Axial_DIN0204_L3.6mm_D1.6mm_P5.08mm_Horizontal
RV1, RV2: 10k; Potentiometer_Trimmer_Bourns_3296W
ResetButton1: Xh_2p; Pin_Header_Straight_1x02_Pitch2.54mm
ShutdownCircuit1: TerminalBlock_2p; TerminalBlock_bornier-2_P5.08mm
ShutdownIND1: Conn_01x04; Pin_Header_Straight_1x04_Pitch2.54mm
U1: 4013; DIP-14_W10.16mm_LongPads
U2: 4049; DIP-16_W10.16mm_LongPads
U3: 4025; DIP-14_W10.16mm_LongPads
U4: TL072; DIP-8_W10.16mm_LongPads
U5: 4081; DIP-14_W10.16mm_LongPads
U6: NE555; DIP-8_W10.16mm_LongPads
U7: 4017; DIP-16_W10.16mm_LongPads
U8: L7805; TO-220-3_Horizontal

Connections:
+5V: BrakeSignal1.1, BrakeSignal2.1, C3.1, RV1.1, RV2.1, U8.3
/BMS_IND: ShutdownIND1.1, U1.2
/BMS_Status: J2.1, R1.2, R2.2, U2.3
/BSPD_Status: U2.11, U3.8, U7.5, U7.13
/Clock: U5.5, U6.3
/IMD_IND: ShutdownIND1.2, U1.12
/IMD_Status: J1.1, R3.2, R4.2, U2.5
/Reset: ResetButton1.1, U2.7
/Shutdown_IN: K1.4, ShutdownCircuit1.1
/Shutdown_OUT: K1.1, ShutdownCircuit1.2
GND: BrakeSignal1.3, BrakeSignal2.3, C1.2, C2.2, C3.2, J1.2, J2.2, PowerSupply1.2, Q1.3, R2.1, R4.1, R8.1, RV1.3, RV2.3, ResetButton1.2, ShutdownIND1.4, U1.7, U2.8, U3.5, U3.7, U4.4, U5.7, U6.1, U7.8, U8.2
unnamed: BrakeSignal1.2, U4.3
unnamed: BrakeSignal2.2, U4.6
unnamed: C1.1, R6.1, U6.2, U6.6
unnamed: D1.2, K1.2, Q1.1
unnamed: Q1.2, R7.1, R8.2
unnamed: R5.1, R6.2, U6.7
unnamed: R7.2, U3.6
unnamed: RV1.2, U4.2
unnamed: RV2.2, U4.5
unnamed: ShutdownIND1.3, U2.15
unnamed: U1.1, U3.1
unnamed: U1.6, U2.2
unnamed: U1.8, U2.4
unnamed: U1.4, U1.10, U2.6, U3.4, U7.15
unnamed: U1.13, U3.2
unnamed: U2.9, U3.9
unnamed: U2.10, U3.3
unnamed: U2.12, U2.14
unnamed: U4.1, U5.1
unnamed: U4.7, U5.2
unnamed: U5.3, U5.6
unnamed: U5.4, U7.14
VCC: C2.1, D1.1, K1.5, PowerSupply1.1, R1.1, R3.1, R5.2, U1.14, U2.1, U3.14, U4.8, U5.14, U6.4, U6.8, U7.16, U8.1
